c4deszes/mini-bicycle/(list of files, cad)

Other CAD files:
parts/Crankset/CrankDrive.stl
parts/Fork/Stanchion.stl
parts/Frame/TopTube.stl
parts/FrontWheel/Hub.stl
parts/Headset/Grip.stl
parts/RearWheel/DiscBrakeMount.stl
parts/SeatPost/SaddleRails.stl
tools/wheel-lacing/Outside1.stl
parts/Crankset/Chainring.stl
parts/Fork/Arch_QuickRelease.stl
parts/Frame/SeatPostTube.stl
parts/FrontWheel/DiscBrakeRotor.stl
parts/Headset/HeadsetFrontPlate.stl
parts/RearWheel/Casette.stl
parts/SeatPost/Saddle.stl
tools/wheel-lacing/Outside2.stl
parts/Crankset/Pedal.stl
parts/Fork/Crown_Steerer.stl
parts/Frame/Chainstays.stl
parts/FrontWheel/Rim.stl
parts/Headset/Handlebar.stl
parts/RearWheel/Hub.stl
parts/SeatPost/SeatPost.stl
tools/wheel-lacing/Middle.stl
parts/Crankset/CrankNonDrive.stl
parts/Fork/Arch_Through.stl
parts/Frame/RearDropoutDrive_QuickRelease.stl
parts/FrontWheel/DiscBrakeMount.stl
parts/Headset/Headset.stl
parts/RearWheel/DiscBrakeRotor.stl
parts/Frame/RearDropoutNonDrive_QuickRelease.stl
parts/RearWheel/Rim.stl
parts/Frame/BottomBracketShell.stl
parts/Frame/RearDropoutNonDrive_Through.stl
parts/Frame/DownTube.stl
parts/Frame/RearDropoutDrive_Through.stl
parts/Frame/HeadTube.stl
parts/Frame/Seatstays.stl
